ttheoha/ECU/README.md

"# ECU Projet"

objectif : recuperer les valeurs et information moteur sans entraver son bon fonctionnement
