ttheoha/ECU/Documents/Dossier ECU.docx

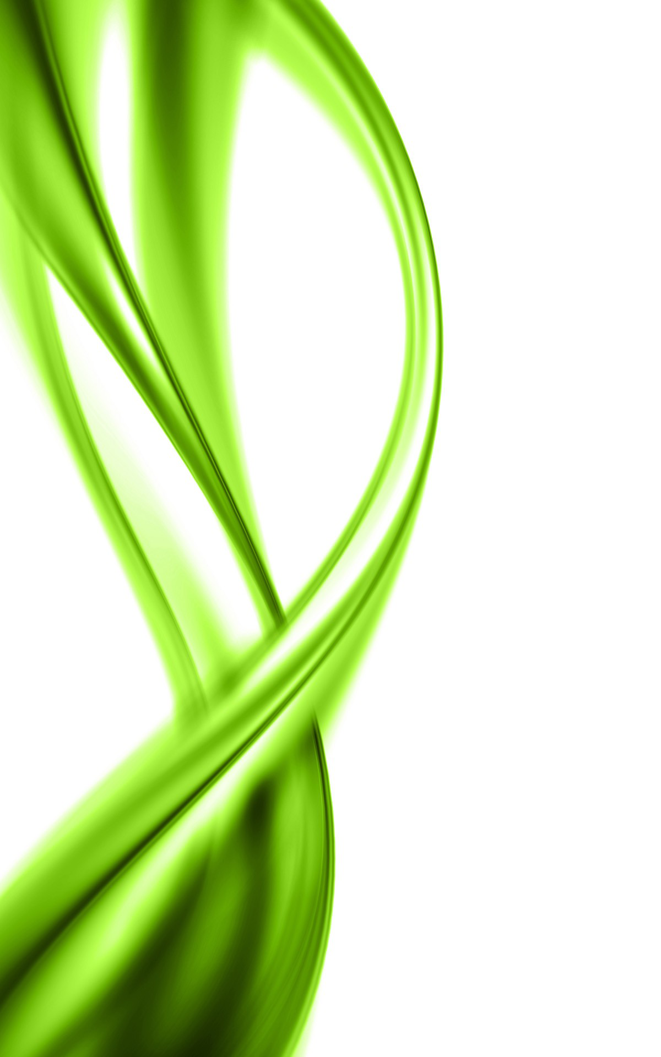
[picture p2: figure]
Afficher l'image d'origine

Projet ECU

Modélisation et conception

d’une carte électronique automobile embarquée

# 1. Definition du besoin

L’objectif de ce projet est de pouvoir monitorer un véhicule tout en ayant la possibilité d’interagir avec lui de façon invisible (pas de modification visuelle sur le véhicule.

Il est évident que la solution doit être sécurisé (éviter les incendies et les court-circuit) et ne doit pas influencer les équipements déjà en place, c’est pourquoi j’utilise des circuits d’alimentation alternatifs avec des sondes dédiées à cette utilisation.

Voici le cahier des charges :

- Température + hydrométrie intérieur véhicule
- Température + hydrométrie extérieur véhicule
- Température eau
- Température échappement
- Température huile
- Pression huile (non supporté)
- 4x relais
- Module Bluetooth
- Module RF433
- Module d’export sur carte SD (non supporté)

# 2. Dévelopement PCB

Le model utilisé pour ce projet se base sur un support double couches de 100*100mm et n’est peuplé que d’un seul côté.

Il est représenté sous cette forme :

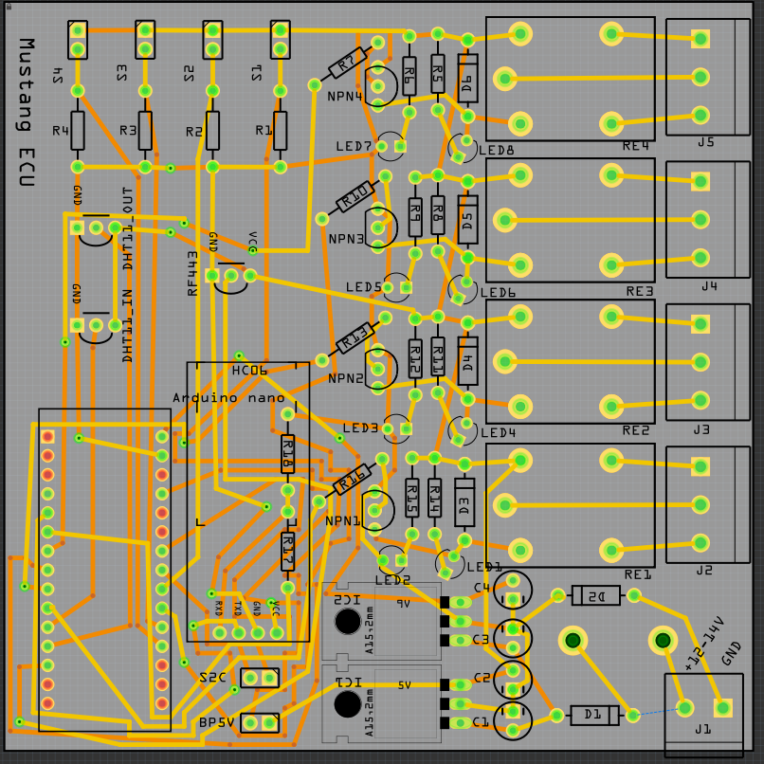
[picture p3: figure]

Par faciliter son développement, il est reparti en 6 secteurs distinct :

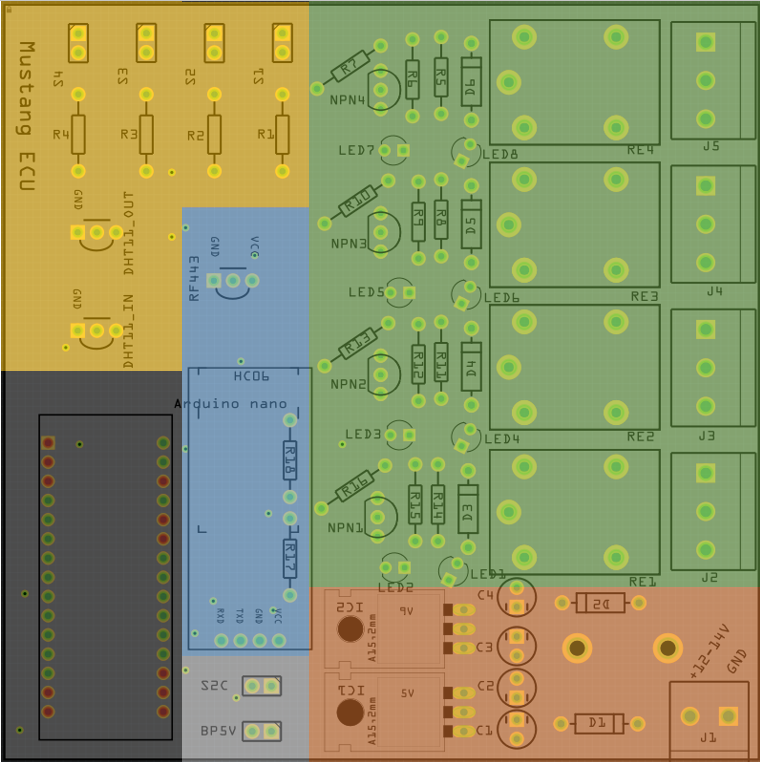
[picture p4: figure]

Chaque module dépend d’un tiers et répond à des caractéristiques précise nécessaire au bon fonctionnement du schéma complet :

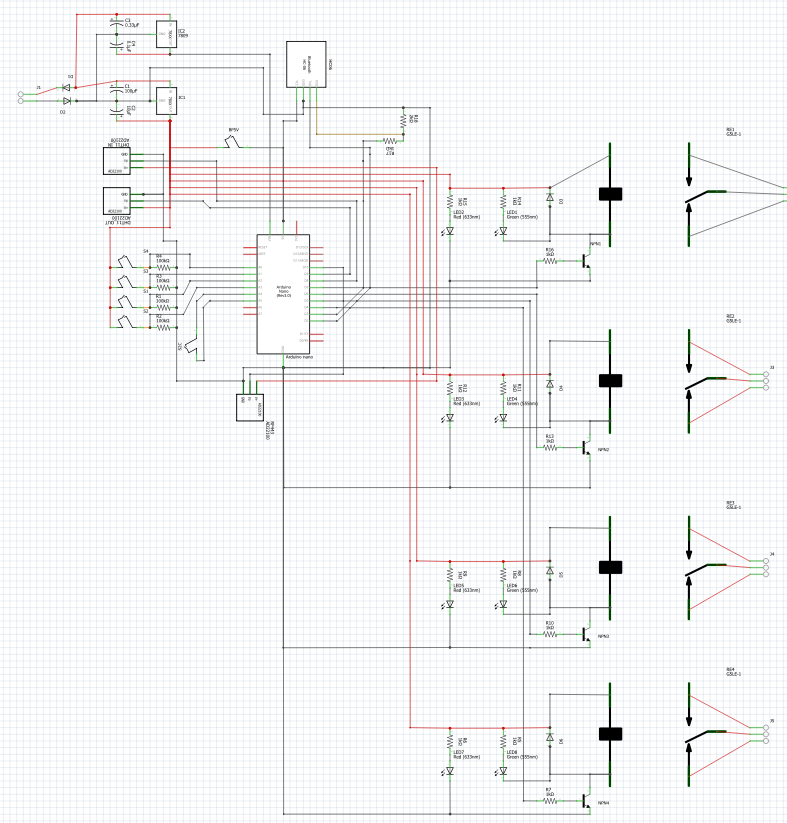
[picture p5: figure]

## 2.1. Secteur rouge : Régulation électrique

La régulation électrique de cette carte est la base de sa conception car elle doit être fiable (pour éviter les variations de tensions sur les composants) et sécurisé (pour éviter d’endommager les composants et protéger tout risque d’incendie).

Ce secteur se présente comme suit :

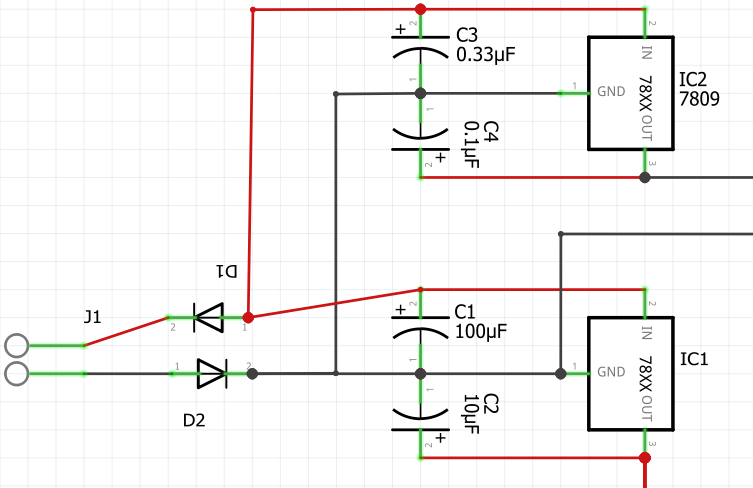
[picture p6: figure]

L’entrée (J1) supporte une tension comprise entre 11 et 14V et est protégé par deux diodes (D1 et D2) ainsi qu’un fusible (3A). La tension est ensuite régulée en deux circuits : L’un par un module L7805 (IC1) régulant le courant à 5V-1.5A pour l’ensemble de la carte, l’autre par un module L7809CV (IC2) fournissant une tension de 9V-1.5A afin d’alimenter l’Arduino. On retrouve différents condensateurs (C1 – C4) en périphérie afin de lisser la charge électrique.

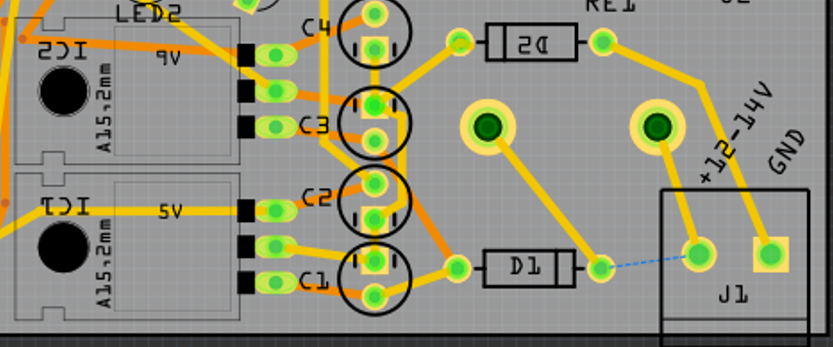
[picture p7: figure]

## 2.2. Secteur vert : modules de relais

La gestion des relais peut être différenciée en 3 groupes basés sur le model ci-dessous :

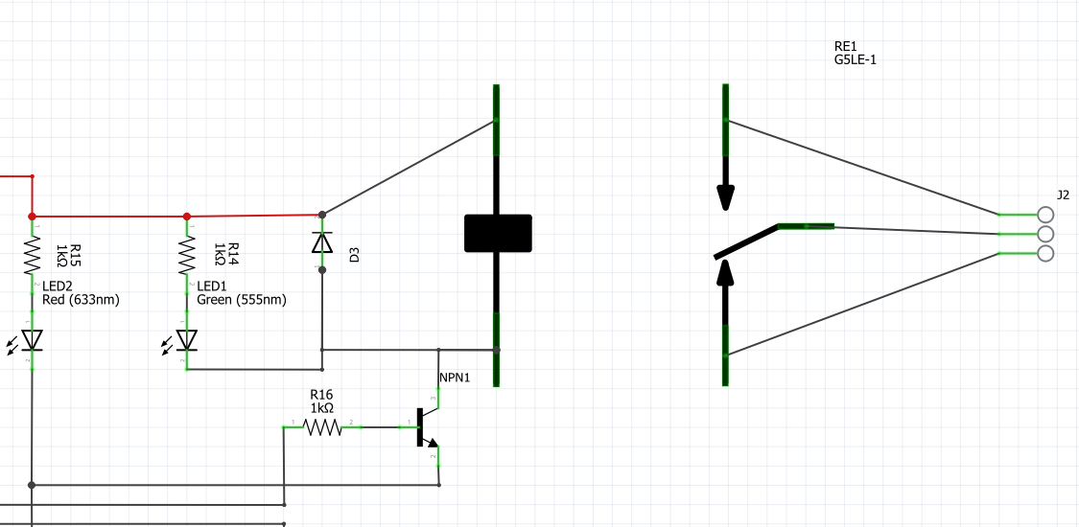
[picture p8: figure]

Ou plus visuellement :

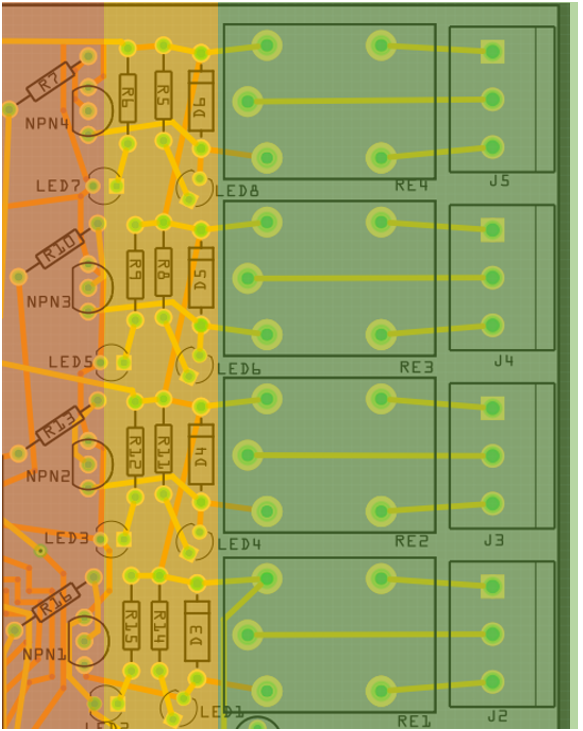
[picture p9: figure]

### 2.2.1. Relais (en vert)

Chaque relais permet deux positions différentes :

- NO : Normalement Ouvert – le courant passe par défaut et est coupé lorsque le signal d’entrée est actif
- NC : Normalement Fermé - le courant est coupé par défaut et passe lorsque le signal d’entrée est actif

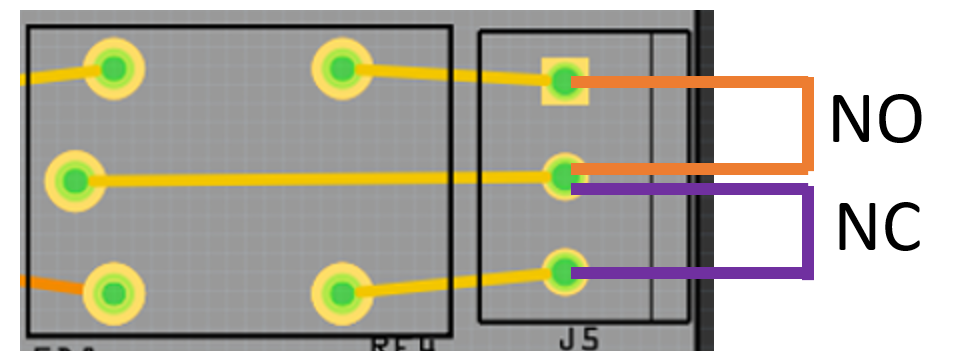
[picture p10: figure]

Chaque module peut supporter 230V et 10A maximum sur ces entrées. Au-delà de ces limites, il y a un risque de dégradation important des composants.

### 2.2.2. Alimentation et temoins (en jaune)

Pour fonctionner, chaque relais doit disposer d’une entrée 5V + GND ainsi qu’une diode anti-retour afin d’isoler la surcharge lors du switch de position.

A cela, j’ai ajouté deux LED : Une rouge témoin de fonctionnement et une verte en témoin d’activité.

### 2.2.3. Communication (en rouge)

L’activation du relais passe par l’initions d’une entrée en 5V. afin de protéger l’entrée de ce compostant, j’utilise un transistor 2N222A331 de type NPN (NPNx) avec une résistance en amont d’1kΩ

## 2.3. Secteur bleu : Interface de communication Bluetooth / RF443

La communication Bluetooth <-> Série est assurée par un module HC06 en interface directe avec l’Arduino via les pins D2 (TXD) et D3 (RXD).

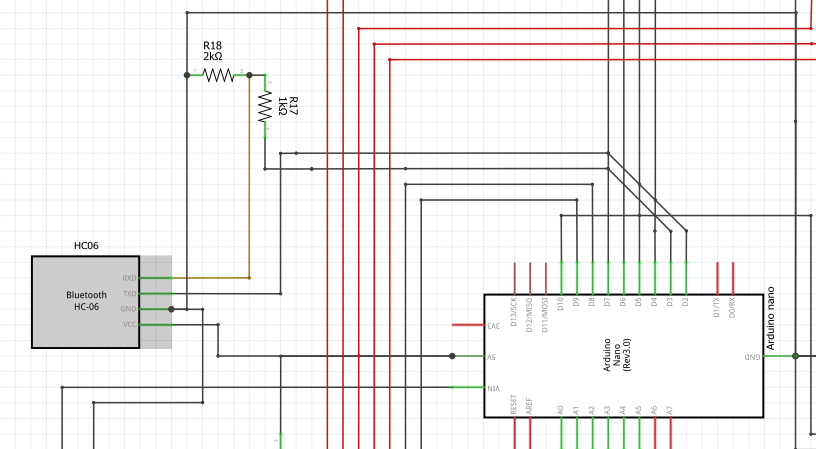
[picture p11: figure]

L’entrée Arduino étant limitée en tension d’entrée, un pont diviseur de résistance afin d’abaisser la tension a 3.33V via le calcul ci-dessous :

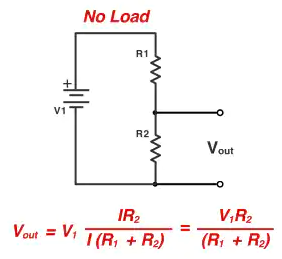
[picture p12: figure]

Ou V1 a une tension d’entrée de 5V, R1 une résistance d’1kΩ et R2 une résistance de 2kΩ.

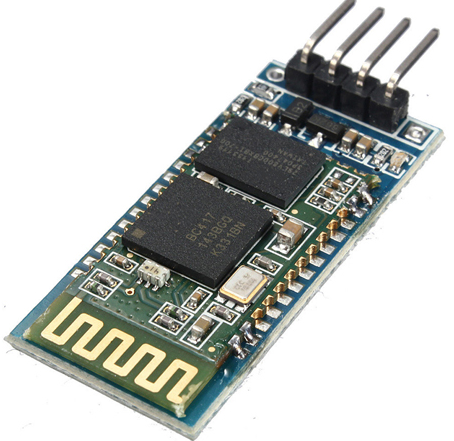
[picture p13: figure]

On retrouve aussi un module RF443 MHz de type « OUT » permettant d’émettre une un signal à la demande.

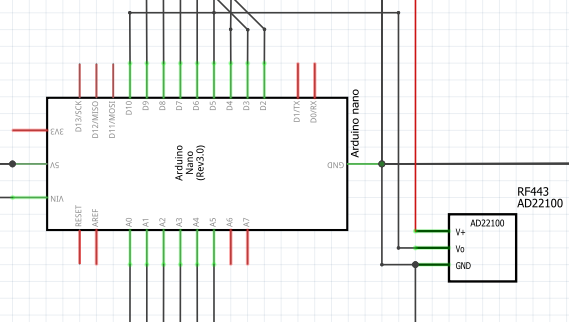
[picture p14: figure]

Ce module alimenté en 5V est connecté à l’entrée D10 de l’Arduino et est piloté, d’une part par l’Arduino et d’autre part du module Bluetooth.

Grace a ce compostant il sera possible d’ouvrir une porte de garage et/ou gérer d’autre compostant fonctionnant sur cette fréquence (ex : cut-out)

## 2.4. Secteur jaune : Sondes

Pour la partie sonde, on retrouve deux modèles différents :

- Les sondes de températures basiques
- Les sondes de température + hydrométrie

Ces sondes dépendent directement du CPU de l’Arduino et disposent d’une arrivée électrique distincte de celle de l’Arduino

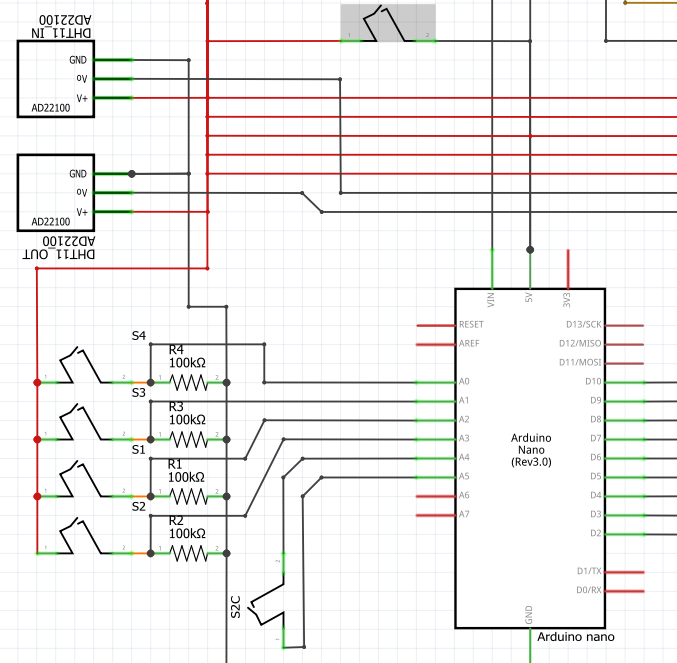
[picture p15: figure]

### 2.4.1. Sonde de température basique

Ces sondes (ou thermistance) (ici nommée S1 S2 S3 et S4 ou « NTC 3950 ») permettent de capter une température comprise entre -30 et +300°. Leur principe de fonctionne se base sur la l’évolution de la résistance de conduction altéré par la dilatation du métal en bout de sonde.

A 25° elle représente une résistance de 100kΩ

Le coefficient BETA d’évolution thermique est consultable en annexe

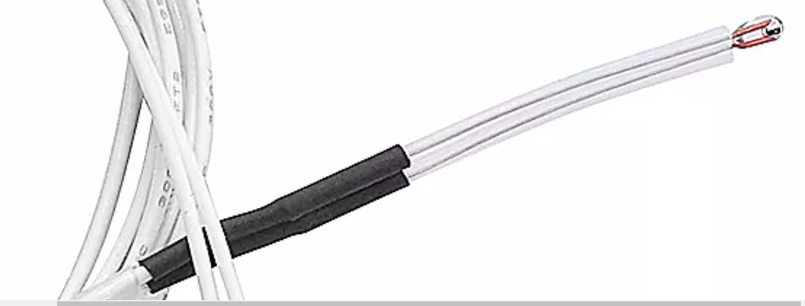
[picture p16: figure]

### 2.4.2. Les sondes de température hydrométrique

Connue sous le nom de DHT11 et/ou DHT22 ces sondes permettent de récupérer la température et l’hydrométrie dans les plages mesures suivantes :

Température : 0 à 50 °C (tolérance ± 2 °C)

Humidité : 20 à 90 % (tolérance ± 5 %)

Elles fonctionnent via des librairies Arduino qui doivent être déclarées directement dans le code

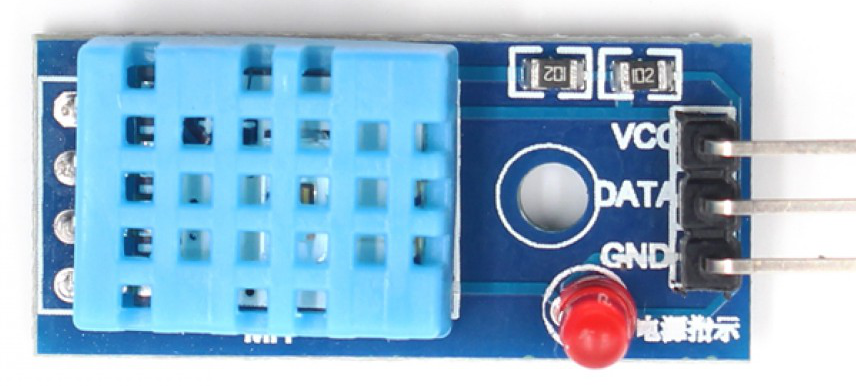
[picture p17: figure]
Capteur d'humidité et de température du module DHT11 avec LED - Arduiner - Arduino Components Shop

## 2.5. Secteur noir : Unité de calcul et d’exécution

L’unité de calcul est un Arduino nano doté d’un ATMega328p. Sa mémoire de 32 kB et ses E/S font de ce circuit un élément idéal pour ce système embarqué et pour des applications nécessitant du multitâches.

L’avantage de cette carte c’est qu’elle comprend déjà l’ensemble des compostant de base nécessaire à l’exécution du programme :

- Microprocesseur : ATMega328
- Cadencement : 16 MHz
- Mémoire flash: 32 kB
- Mémoire SRAM: 2 kB
- Mémoire EEPROM: 1 kB
- Interfaces :
  - 14 broches d'E/S dont 6 PWM
  - 8 entrées analogiques 10 bits
  - bus série, I2C et SPI
- Intensité par E/S : 40 mA

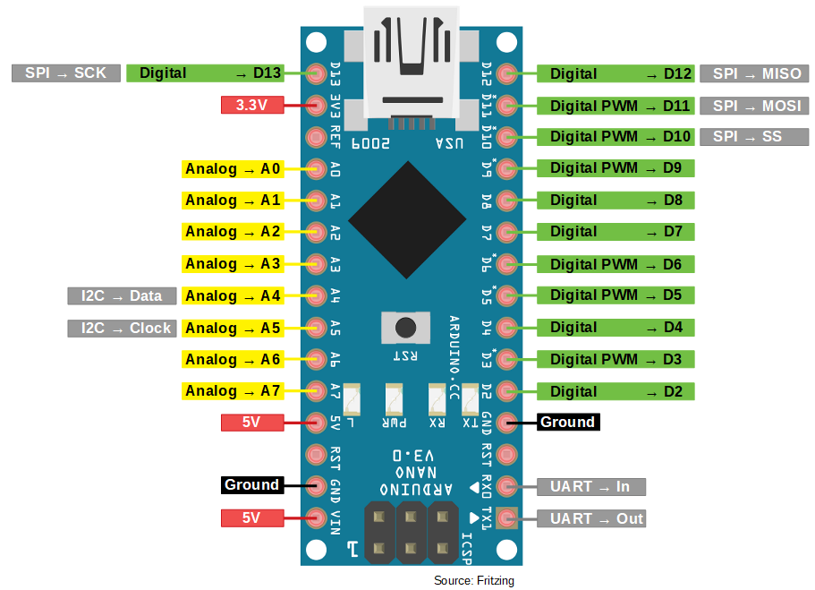
[picture p18: figure]
Arduino Nano Tutorial [Pinout]

Dans ce projet, cet Arduino est alimenté soit directement par USB, soit par le circuit d’alimentation 9V via les broches VIN et GND.

## 2.6. Secteur gris : Auxiliaire et debug

Ce secteur est prédisposé au débogage du circuit et à l’intégration de nouveautés.

On retrouve :

- BP5V : le ByPass5V permet d’alimenter la carte en 5V en utilisant l’Arduino comme source. Grâce à un pont physique, il est possible d’alimenter l’entièreté de la carte sans disposer d’une source 12V régulée.
- I2C : l’I2C permet de faire communiquer deux Arduino. Grace a cette interface, il sera possible d’étendre les possibilités futures.

# 3. Developement firmware

## 3.1. Configuration Bluetooth

Le code HC06 permet de configurer le module Bluetooth. Il permet en autre de :

- Lier le module à l’Arduino
- Donner un nom au réseau
- Modifier le code d’accès
- Modifier la vitesse de transmission de donnée

/* HC-06 Config est un programme qui permet de configurer le module Bluetooth*/

// Création d'une liaison série sur les broches 2 et 3

#include <SoftwareSerial.h> // appel de la bibliothèque

SoftwareSerial HC06(2, 3); // RX, TX

void setup()

{

HC06.begin(9600); // initialisation connexion série Bluetooth à 9600 bauds

Serial.begin(9600); // initialisation liaison série à 9600 bauds

Serial.println("Entrer la commande AT:");

}

void loop()

{

// si le HC-06 transmet, on écrit le message dans le moniteur série

if (HC06.available())

{

Serial.write(HC06.read());

}

// si on écrit dans le moniteur série, on transmet le message dans le module HC-06

if (Serial.available())

{

HC06.write(Serial.read());

}

}

## 3.2. Configuration Arduino

Le programme est cadencé en trois sous programmes :

Phase 1 (en bleu) :

- L’initions : C’est la phase de chargement des dépendances, des librairies et de la connexion Bluetooth. C’est aussi ici que le programme défini ses variables nécessaire aux autres fonctions

Phase 2 (en vert et orange) :

- L’exécution : On retrouve ici la gestion de la partie dynamique du programme qui exploite deux moteurs parallèles :
  - Réception de données : ce moteur exploite les sondes et remonte l’information au module Bluetooth
  - Interaction : ce moteur attend un ordre émanant du module Bluetooth afin d’interagir avec les relais ou le module RF.

Début | | | | | Fin

L’avantage de l’exploitation parallèle de la phase 2 c’est qu’elle réduit drastiquement le temps de réponse du programme. Il est aussi possible d’ouvrir et fermer un relais, sans attendre la fin de la boucle du programme.

## 3.3. Retours HID

L’utilisation de la carte électronique au travers du firmwaire est possible grâce à l’interface HID-BL ci-dessous :

### 3.3.1. Gestion des relais

Type : émission

Type Relais N°1 Statu : Open/Close

- Relais 1 :
  - Fermé à ouvert : R1O
  - Ouvert à fermer : R1C
- Relais 2 :
  - Fermé à ouvert : R2O
  - Ouvert à fermer : R2C
- Relais 3 :
  - Fermé à ouvert : R3O
  - Ouvert à fermer : R3C
- Relais 4 :
  - Fermé à ouvert : R4O
  - Ouvert à fermer : R4C

### 3.3.2. Gestion des sondes de temperature basique

Type : Réception

A 25

Sonde S1 temp a 25°

- S1
  - Retour : A+Valeur
- S2
  - Retour : B+Valeur
- S3
  - Retour : C+Valeur
- S4
  - Retour : D+Valeur

### 1.1.1. Gestion des sondes de temperature hydrométrique

Type : Réception

E 25

Sonde S1 temp a 25°

F 50%

Sonde S1 humidité a 25°

- DHTOUT
  - Retour :
    - E+Valeur (T)
    - F+Valeur (H)
- DHTIN
  - Retour :
    - G+Valeur (T)
    - H+Valeur (H)

### 1.1.2. Gestion module 433Mhz

Type : émission

- RF433 :
  - Bouton 1 : X
  - Bouton 2 : Y
  - Bouton 3 : Z

# 4. Assemblage PCB

# 5. annexes

## 5.1. Boite de protection

## 5.2. R&T Table

R25=100KΩ TOLERANCE:±1% B25/50=3950K TOLERANCE:±1% (P209-15A)
TEMP(℃) | RESISTANCE(KΩ) | | | RESISST-TOL(%) | | TEMP-TOL(℃)
| MIN | CENTER | MAX | △R | -△R | △T | -△T
-55 | 10477.600 | 11093.800 | 11745.000 | 5.869 | -5.553 | 0.729 | -0.690
-54 | 9600.550 | 10156.100 | 10742.700 | 5.776 | -5.470 | 0.725 | -0.687
-53 | 8809.950 | 9311.690 | 9841.020 | 5.684 | -5.388 | 0.722 | -0.684
-52 | 8096.030 | 8549.810 | 9028.120 | 5.594 | -5.307 | 0.718 | -0.681
-51 | 7450.220 | 7861.200 | 8294.020 | 5.505 | -5.227 | 0.714 | -0.678
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
S1 | Port 2 pins
S2 | Port 2 pins
S3 | Port 2 pins
S4 | Port 2 pins
IN | Sonde | DHT11
OUT | Sonde | DHT11
IC1 | Régulateur de tension | L7805CV
IC1 | Régulateur de tension | L7809CV

Modélisation et conception d’une carte électronique automobile embarquée 6/6
