ttheoha/ECU/Schemas + PCB/Capture.JPG

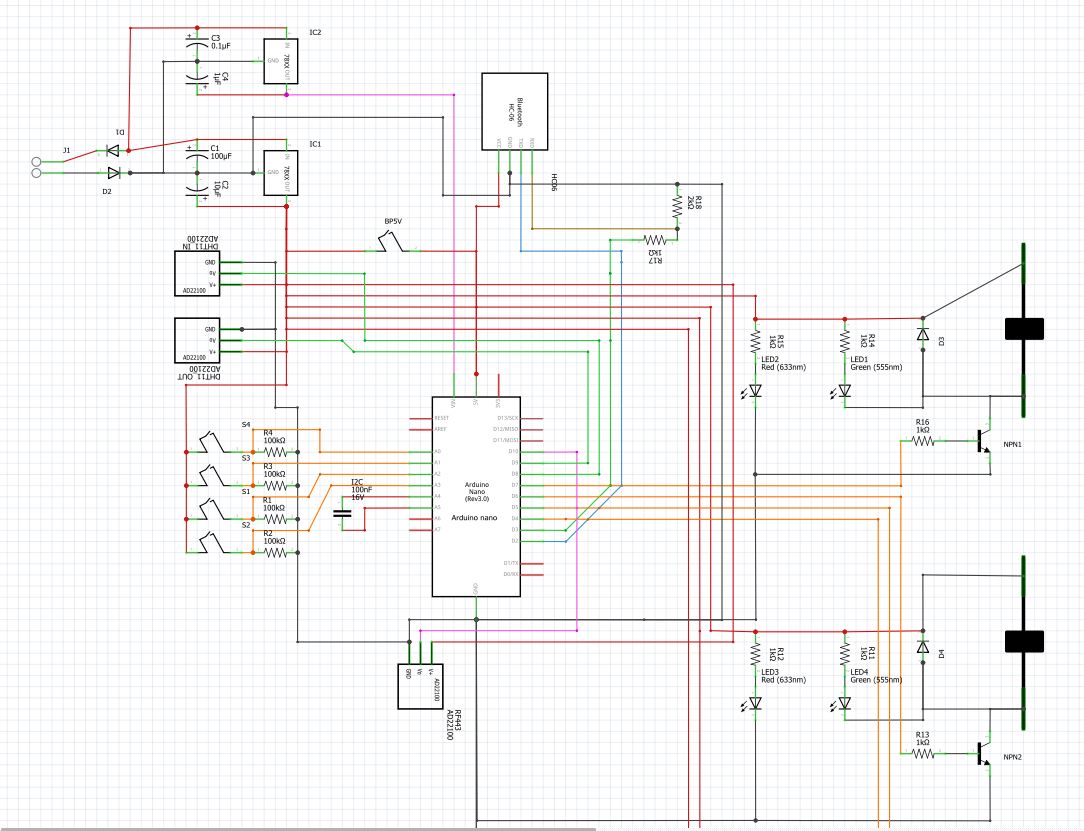
Schemas + PCB/Capture.JPG
