ttheoha/ECU/Schemas + PCB/logiciel/fritzing.0.9.3b.32.pc/help/images/assoc1.PNG

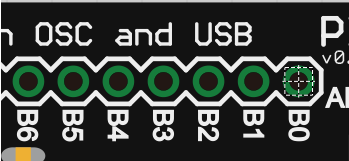
Schemas + PCB/logiciel/fritzing.0.9.3b.32.pc/help/images/assoc1.PNG
