ttheoha/ECU/Schemas + PCB/logiciel/fritzing.0.9.3b.32.pc/help/images/highlight3.png

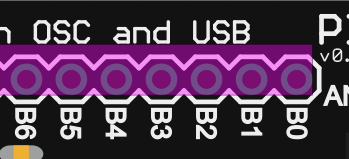
Schemas + PCB/logiciel/fritzing.0.9.3b.32.pc/help/images/highlight3.png
