ttheoha/ECU/Schemas + PCB/logiciel/fritzing.0.9.3b.32.pc/help/images/pin3.PNG

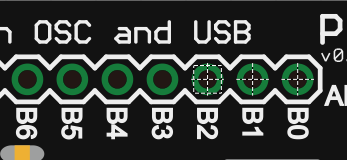
Schemas + PCB/logiciel/fritzing.0.9.3b.32.pc/help/images/pin3.PNG
