ttheoha/ECU/(list of files, drawings)

Other design files:
Schemas + PCB/logiciel/fritzing.0.9.3b.32.pc/sketches/core/7Segment_direct.fzz
Schemas + PCB/logiciel/fritzing.0.9.3b.32.pc/sketches/core/555TouchSwitch.fzz
Schemas + PCB/logiciel/fritzing.0.9.3b.32.pc/sketches/core/Amplification.fzz
Schemas + PCB/logiciel/fritzing.0.9.3b.32.pc/sketches/core/AnalogInputFSR.fzz
Schemas + PCB/logiciel/fritzing.0.9.3b.32.pc/sketches/core/AnalogInputOutput.fzz
Schemas + PCB/logiciel/fritzing.0.9.3b.32.pc/sketches/core/AnalogInputPot.fzz
Schemas + PCB/logiciel/fritzing.0.9.3b.32.pc/sketches/core/AnalogInputThermistor.fzz
Schemas + PCB/logiciel/fritzing.0.9.3b.32.pc/sketches/core/AnalogInputToServo.fzz
Schemas + PCB/logiciel/fritzing.0.9.3b.32.pc/sketches/core/Arduino-no-FTDI.fzz
Schemas + PCB/logiciel/fritzing.0.9.3b.32.pc/sketches/core/ArduinoISP.fzz
Schemas + PCB/logiciel/fritzing.0.9.3b.32.pc/sketches/core/Barebones Arduino (stripboard).fzz
Schemas + PCB/logiciel/fritzing.0.9.3b.32.pc/sketches/core/Button.fzz
Schemas + PCB/logiciel/fritzing.0.9.3b.32.pc/sketches/core/color-fader.fzz
Schemas + PCB/logiciel/fritzing.0.9.3b.32.pc/sketches/core/CosmicRayGun.fzz
Schemas + PCB/logiciel/fritzing.0.9.3b.32.pc/sketches/core/Countdown.fzz
Schemas + PCB/logiciel/fritzing.0.9.3b.32.pc/sketches/core/DC_motor_control.fzz
Schemas + PCB/logiciel/fritzing.0.9.3b.32.pc/sketches/core/Fritzing Creator Kit DE+EN/creator-kit-de/Fritzing/Blink.fzz
Schemas + PCB/logiciel/fritzing.0.9.3b.32.pc/sketches/core/Fritzing Creator Kit DE+EN/creator-kit-de/Fritzing/Fading.fzz
Schemas + PCB/logiciel/fritzing.0.9.3b.32.pc/sketches/core/Fritzing Creator Kit DE+EN/creator-kit-de/Fritzing/FlipFlop.fzz
Schemas + PCB/logiciel/fritzing.0.9.3b.32.pc/sketches/core/Fritzing Creator Kit DE+EN/creator-kit-de/Fritzing/H-Bridge.fzz
Schemas + PCB/logiciel/fritzing.0.9.3b.32.pc/sketches/core/Fritzing Creator Kit DE+EN/creator-kit-de/Fritzing/Lauflicht.fzz
Schemas + PCB/logiciel/fritzing.0.9.3b.32.pc/sketches/core/Fritzing Creator Kit DE+EN/creator-kit-de/Fritzing/Lichtautomatik.fzz
Schemas + PCB/logiciel/fritzing.0.9.3b.32.pc/sketches/core/Fritzing Creator Kit DE+EN/creator-kit-de/Fritzing/Matrix.fzz
Schemas + PCB/logiciel/fritzing.0.9.3b.32.pc/sketches/core/Fritzing Creator Kit DE+EN/creator-kit-de/Fritzing/Nachtlicht.fzz
Schemas + PCB/logiciel/fritzing.0.9.3b.32.pc/sketches/core/Fritzing Creator Kit DE+EN/creator-kit-de/Fritzing/PingPong.fzz
Schemas + PCB/logiciel/fritzing.0.9.3b.32.pc/sketches/core/Fritzing Creator Kit DE+EN/creator-kit-de/Fritzing/Potentiometer.fzz
Schemas + PCB/logiciel/fritzing.0.9.3b.32.pc/sketches/core/Fritzing Creator Kit DE+EN/creator-kit-de/Fritzing/ProcessingRGB.fzz
Schemas + PCB/logiciel/fritzing.0.9.3b.32.pc/sketches/core/Fritzing Creator Kit DE+EN/creator-kit-de/Fritzing/Servo.fzz
Schemas + PCB/logiciel/fritzing.0.9.3b.32.pc/sketches/core/Fritzing Creator Kit DE+EN/creator-kit-de/Fritzing/Synthesizer.fzz
Schemas + PCB/logiciel/fritzing.0.9.3b.32.pc/sketches/core/Fritzing Creator Kit DE+EN/creator-kit-de/Fritzing/TwitterSaurus.fzz
Schemas + PCB/logiciel/fritzing.0.9.3b.32.pc/sketches/core/Fritzing Creator Kit DE+EN/creator-kit-de/Fritzing/Verstaerkung.fzz
Schemas + PCB/logiciel/fritzing.0.9.3b.32.pc/sketches/core/Fritzing Creator Kit DE+EN/creator-kit-de/Fritzing/Wahrsager.fzz
Schemas + PCB/logiciel/fritzing.0.9.3b.32.pc/sketches/core/Fritzing Creator Kit DE+EN/creator-kit-de/Fritzing/Zaubertafel.fzz
Schemas + PCB/logiciel/fritzing.0.9.3b.32.pc/sketches/core/Fritzing Creator Kit DE+EN/creator-kit-en/Fritzing/Amplification.fzz
Schemas + PCB/logiciel/fritzing.0.9.3b.32.pc/sketches/core/Fritzing Creator Kit DE+EN/creator-kit-en/Fritzing/AutomaticLightingSystem.fzz
Schemas + PCB/logiciel/fritzing.0.9.3b.32.pc/sketches/core/Fritzing Creator Kit DE+EN/creator-kit-en/Fritzing/Blink.fzz
Schemas + PCB/logiciel/fritzing.0.9.3b.32.pc/sketches/core/Fritzing Creator Kit DE+EN/creator-kit-en/Fritzing/ChaserLights.fzz
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
