ttheoha/ECU/(commit log)

2026-05-03 Rename V8.PCB mamie_Blue.fzz to PCB.fzz
    [PCB mamie_Blue.fzz]
2026-05-03 Rename PCB mamie_Blue.fzz to PCB.fzz
    [PCB.fzz]
